marcorispoli/PCB334/(list of files, cad)

Other CAD files:
ESECUTIVI/PM25-334-1.dwg
LAYOUT/25-334-1.dwg
ESECUTIVI/PF25-334-1.dwg
