marcorispoli/PCB334/ORCAD/SE25-334-1.pdf

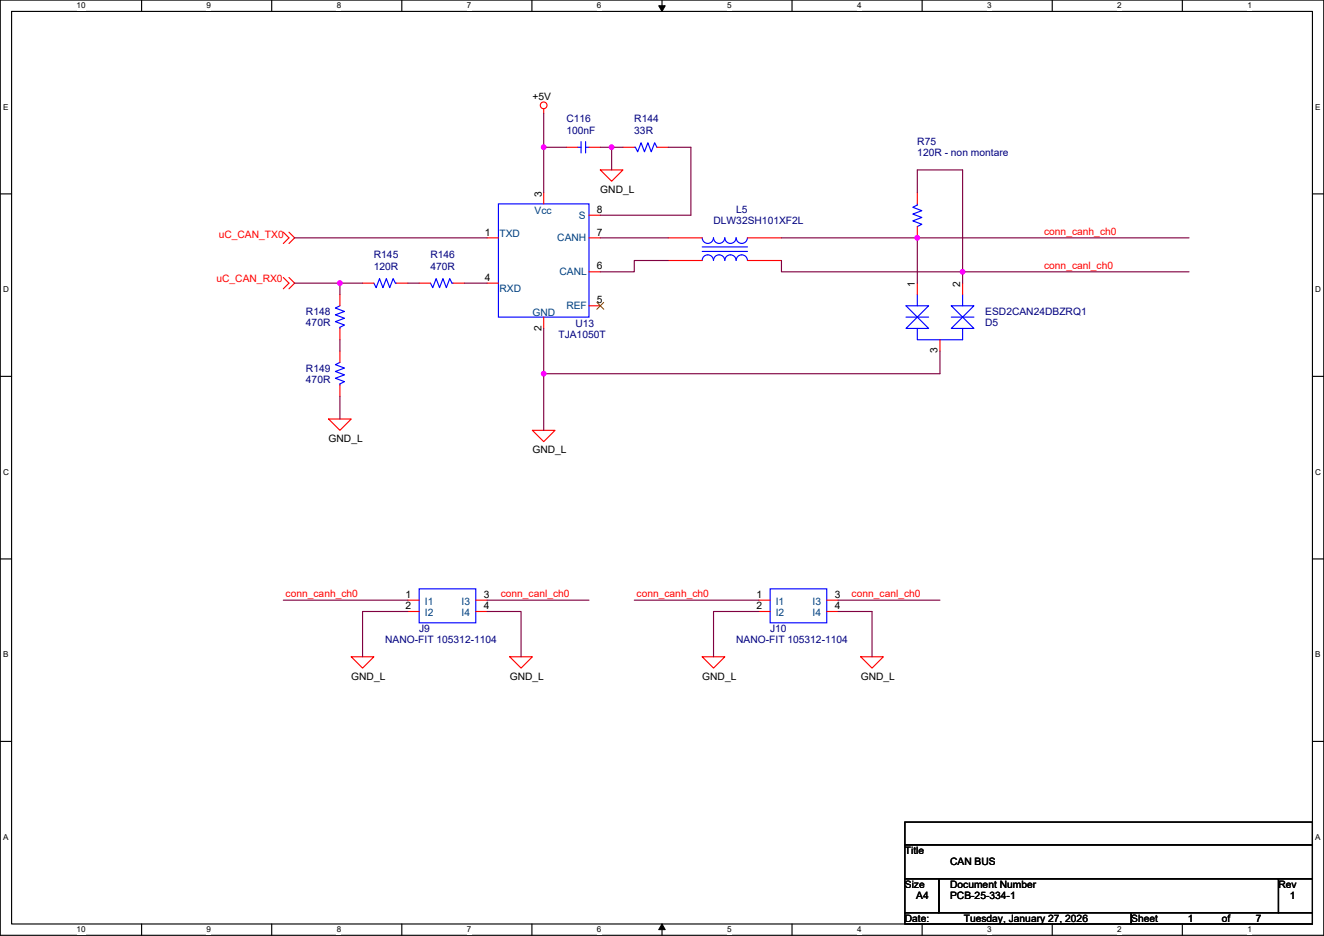
[picture p24: page 1]

Size A4 | Document Number PCB-25-334-1 | Rev 1

Date: Tuesday, January 27, 2026 Tuesday, January 27, 2026 Tuesday, January 27, 2026 | Sheet 1 1 1 of 7 7 7

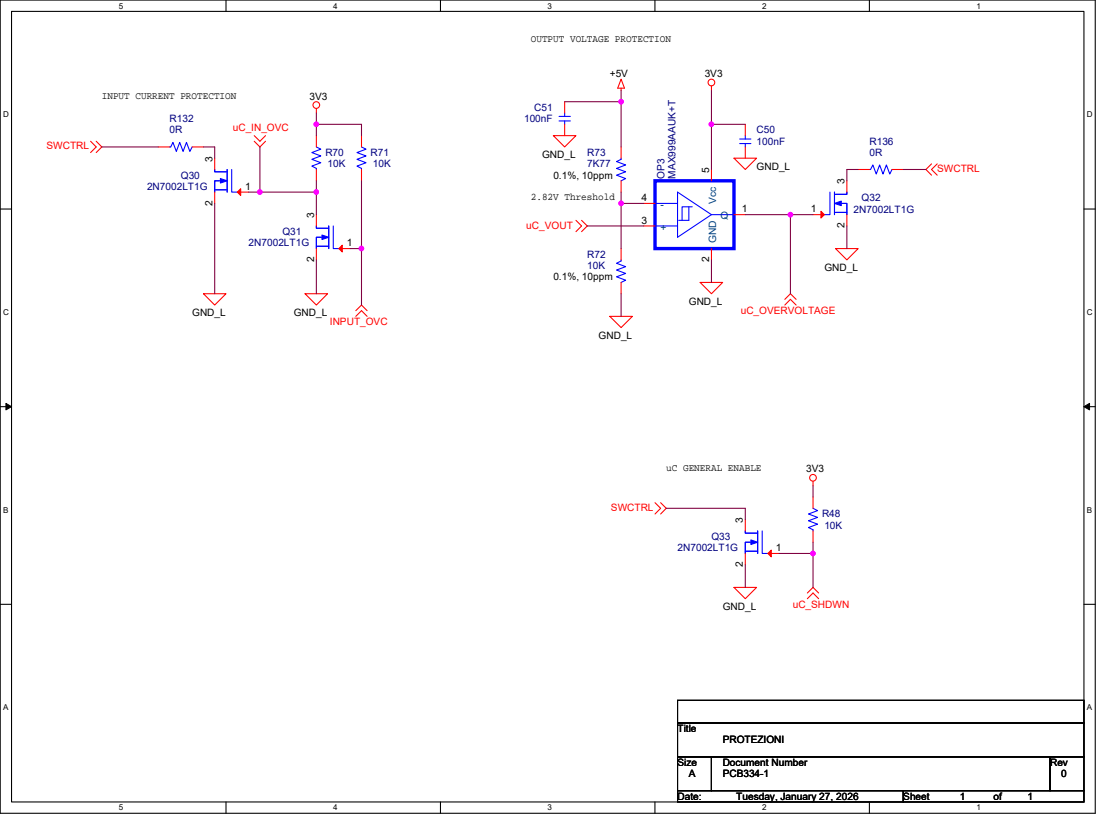
[picture p25: page 2]

A A A | PCB334-1 PCB334-1 PCB334-1 | 0 0 0

Tuesday, January 27, 2026 Tuesday, January 27, 2026 Tuesday, January 27, 2026 | 1 1 1

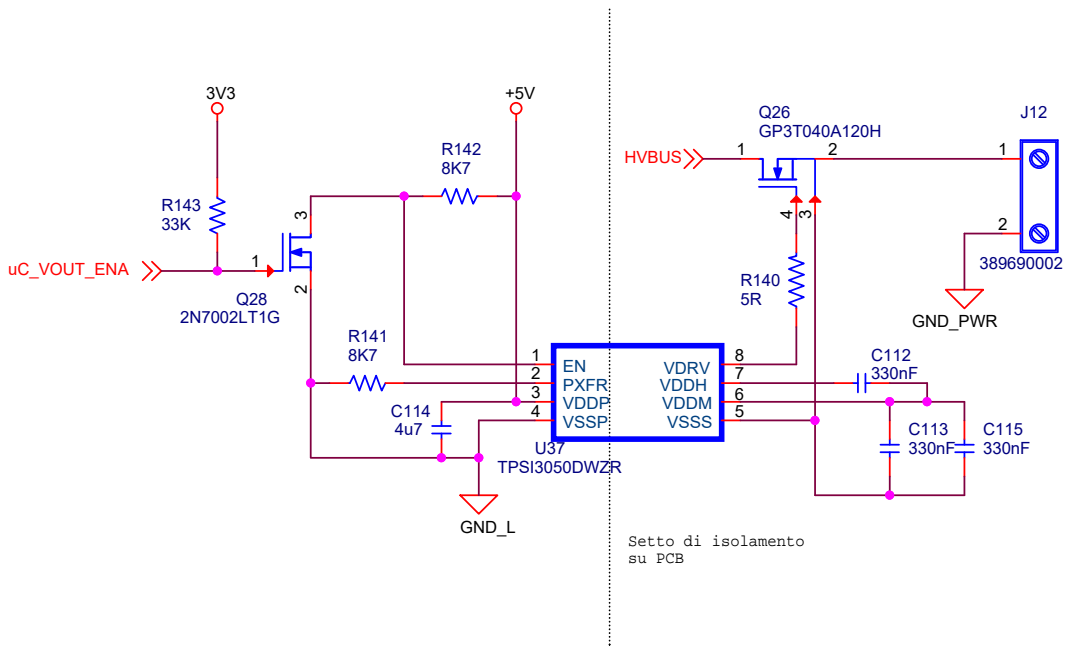
[picture p26: page 3]

Wednesday, January 28, 2026 Wednesday, January 28, 2026 Wednesday, January 28, 2026 | 1 1 1

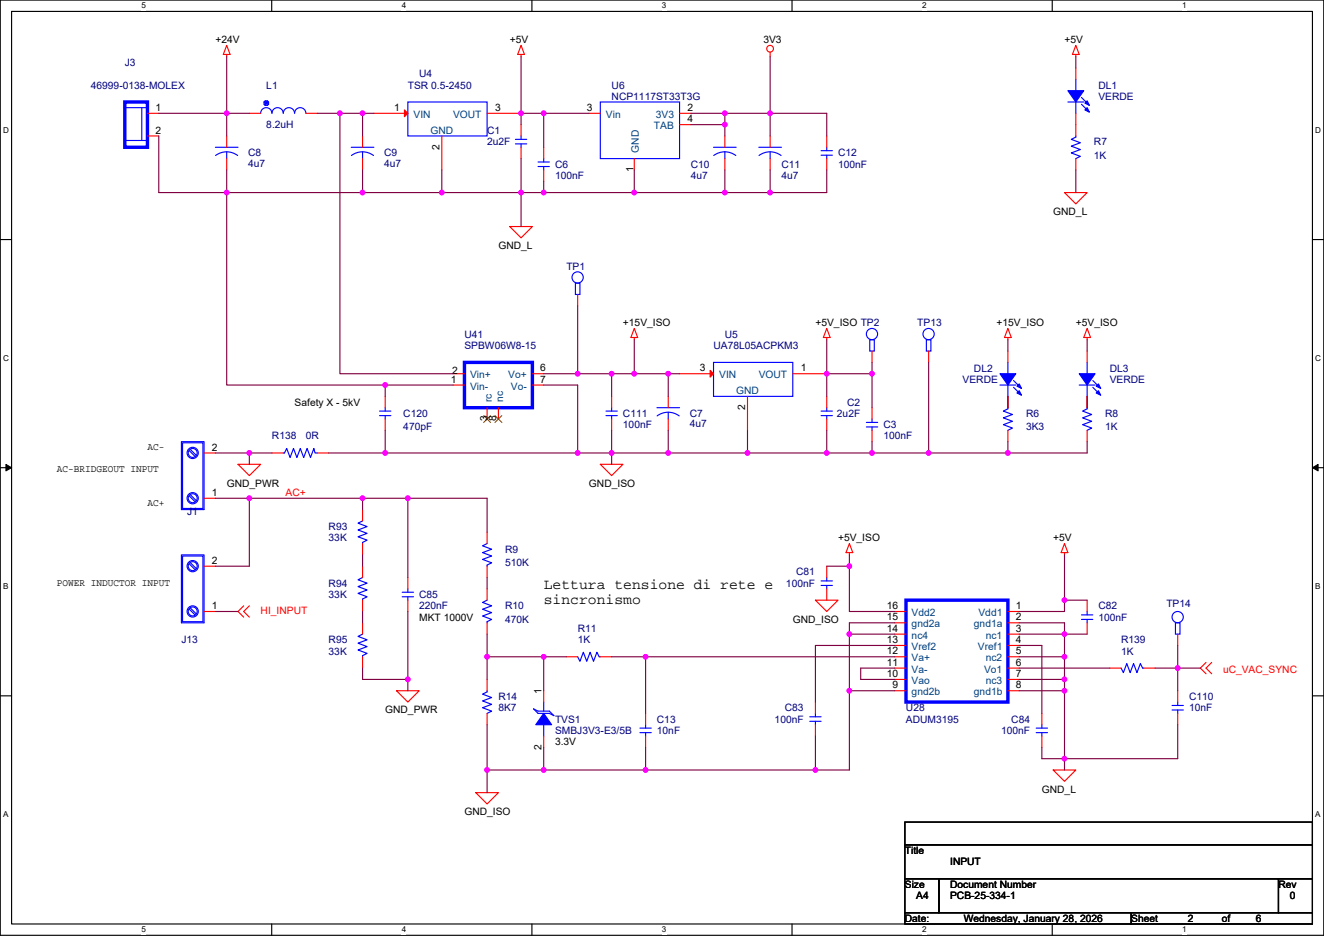
[picture p27: page 4]

AC+ AC-BRIDGEOUT INPUT

## Vref = 0.00477 * Vout Vref(560) = 2.67V

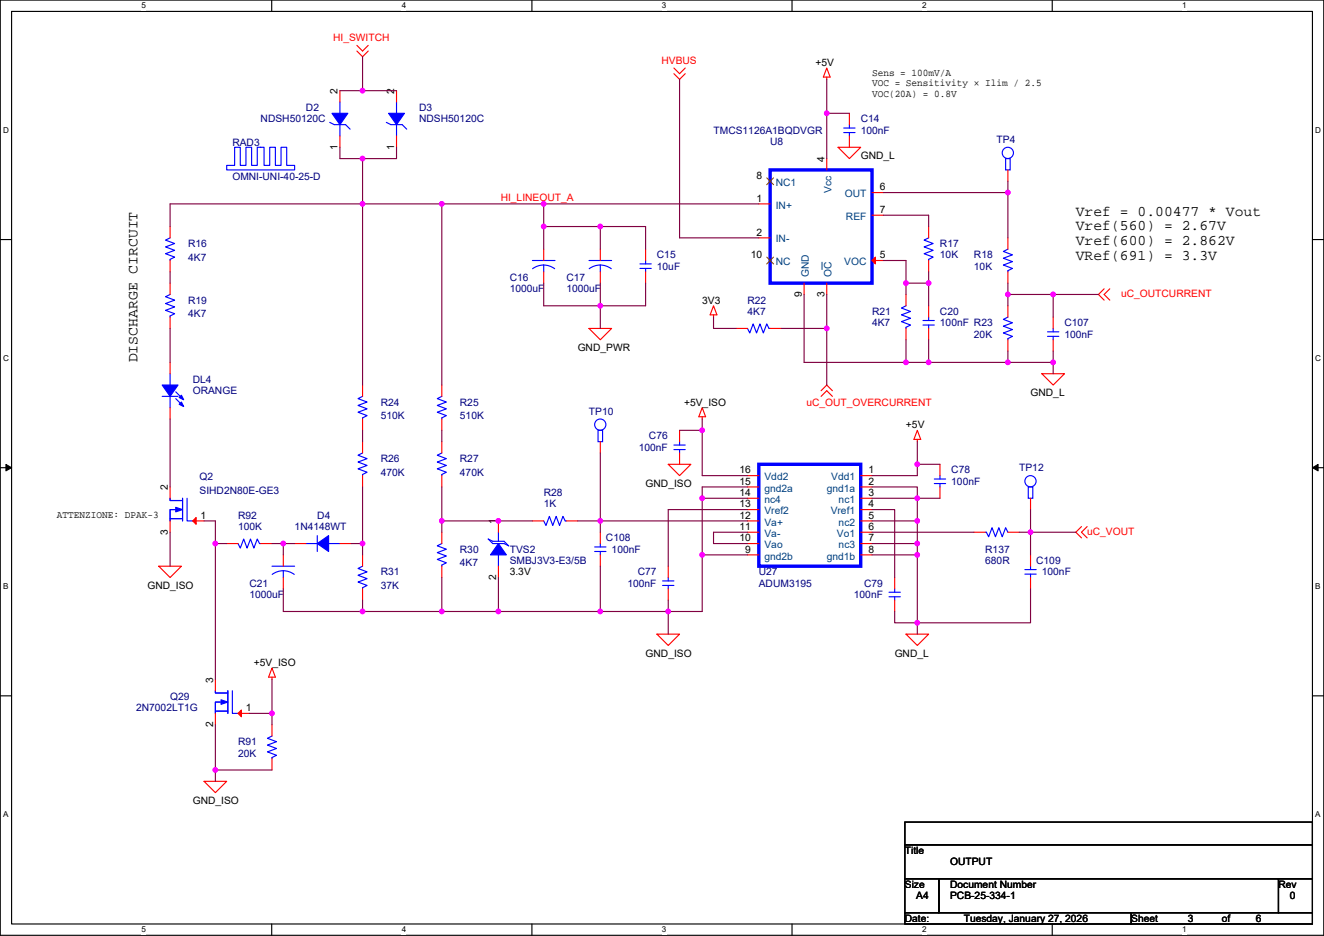
[picture p28: page 5]

# PER ALTE PRESTAZIONI UTILIZZARE: SiC MOSFET ->IMZC120R017M2HXKSA1

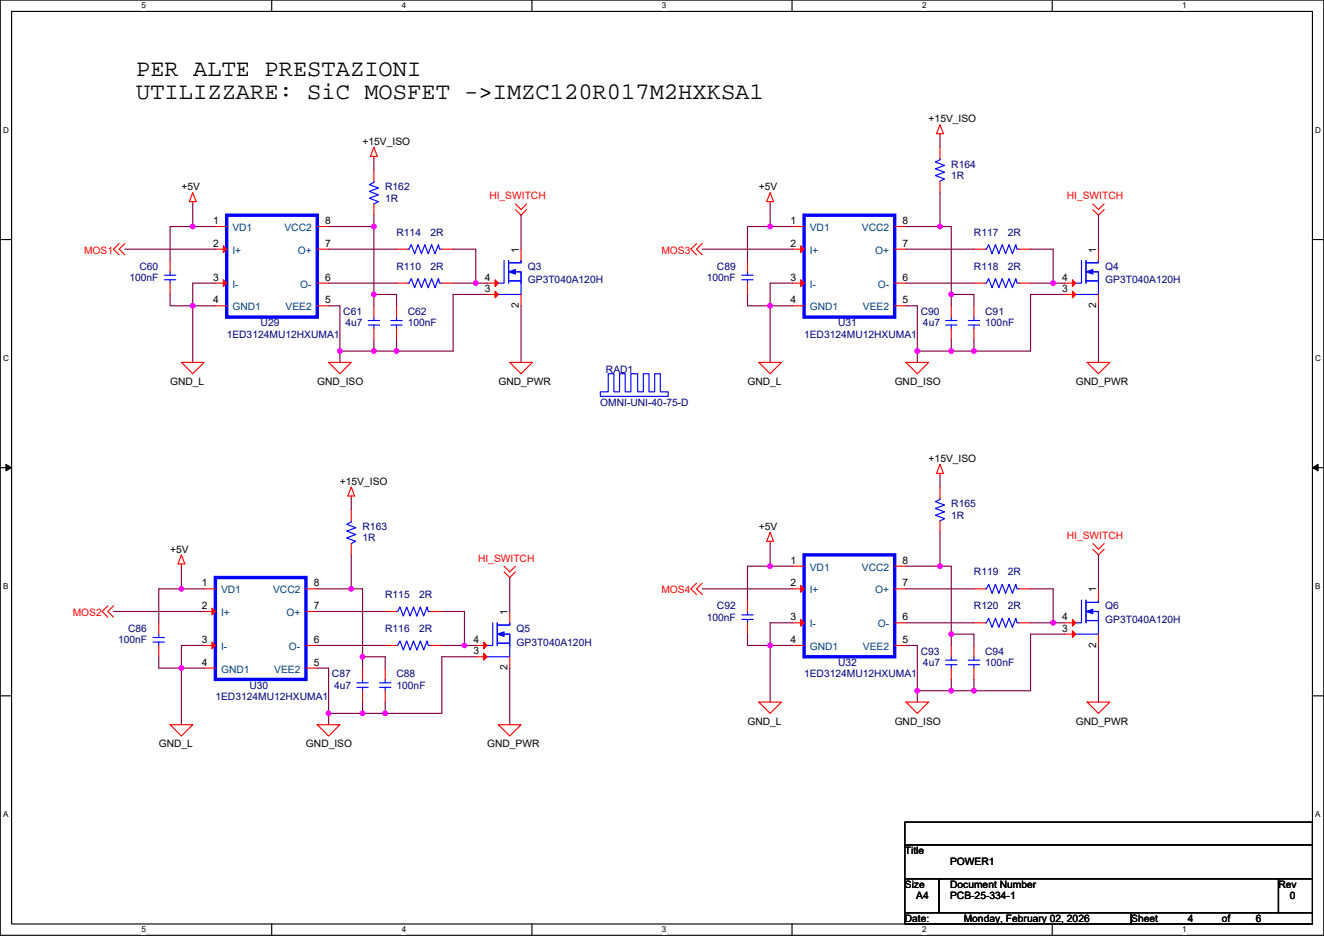
[picture p29: page 6]

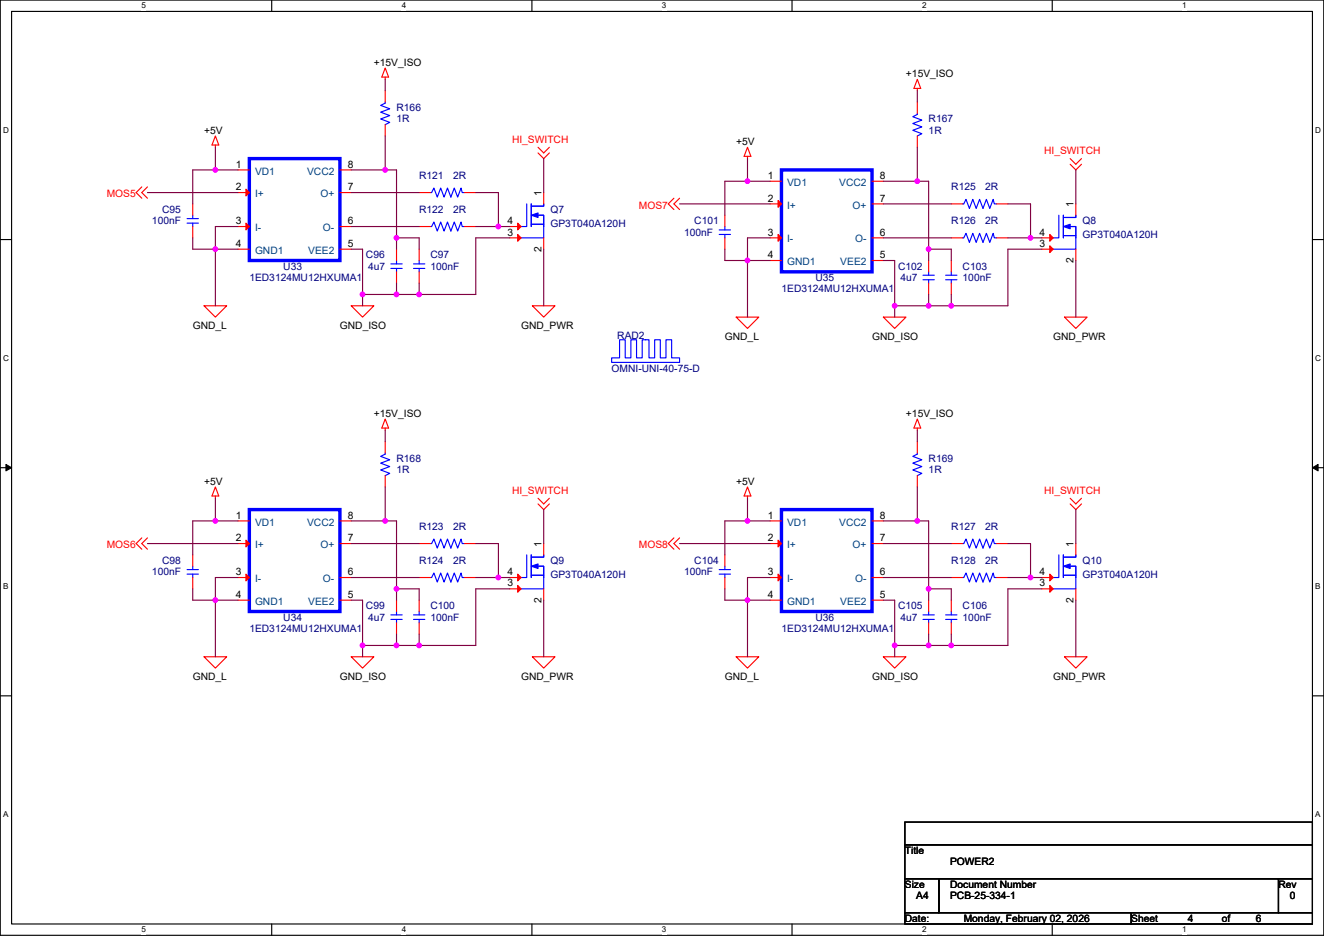
[picture p30: page 7]

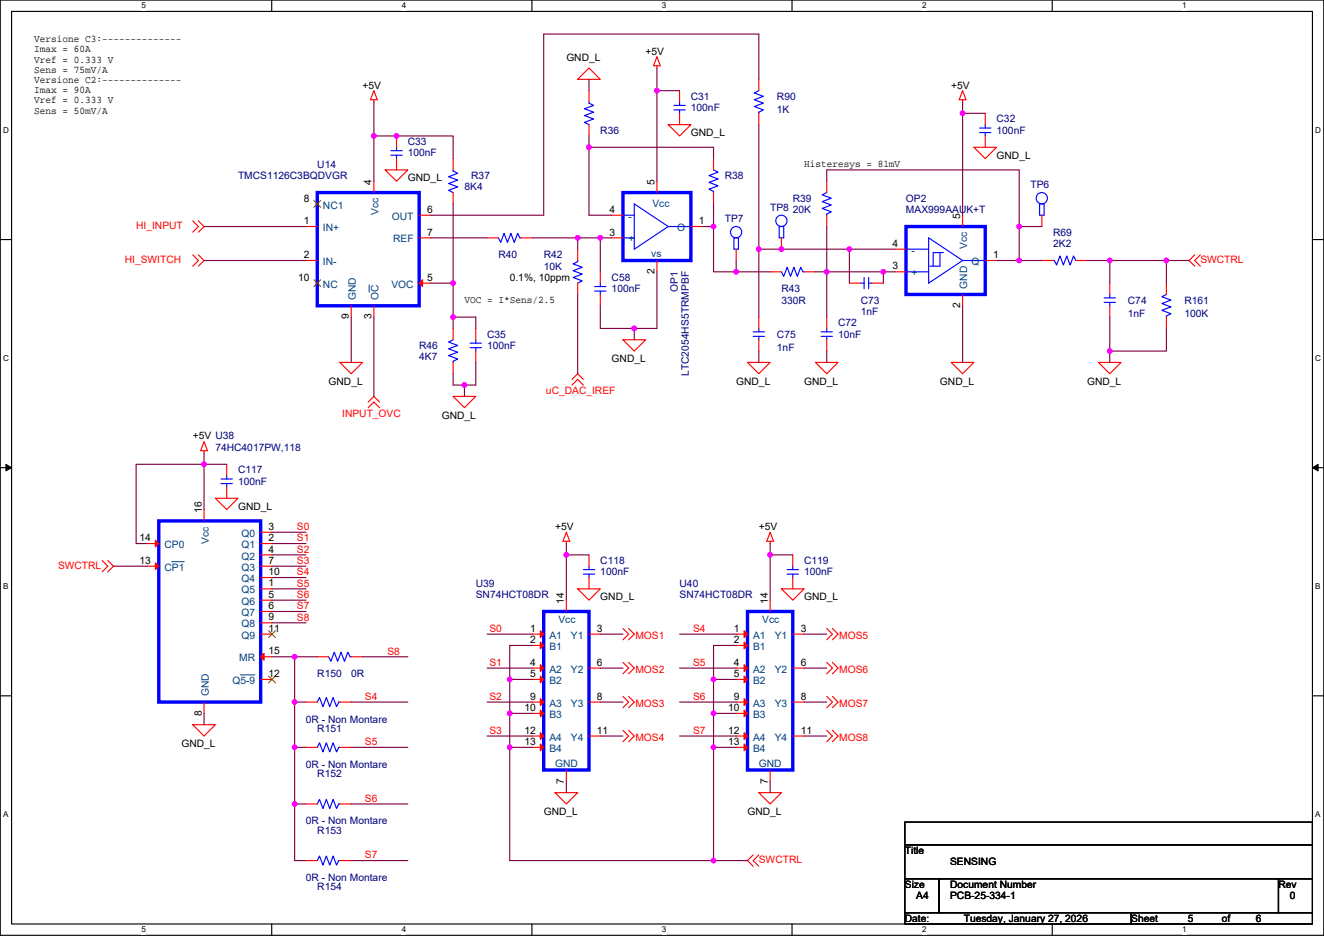
[picture p31: page 8]

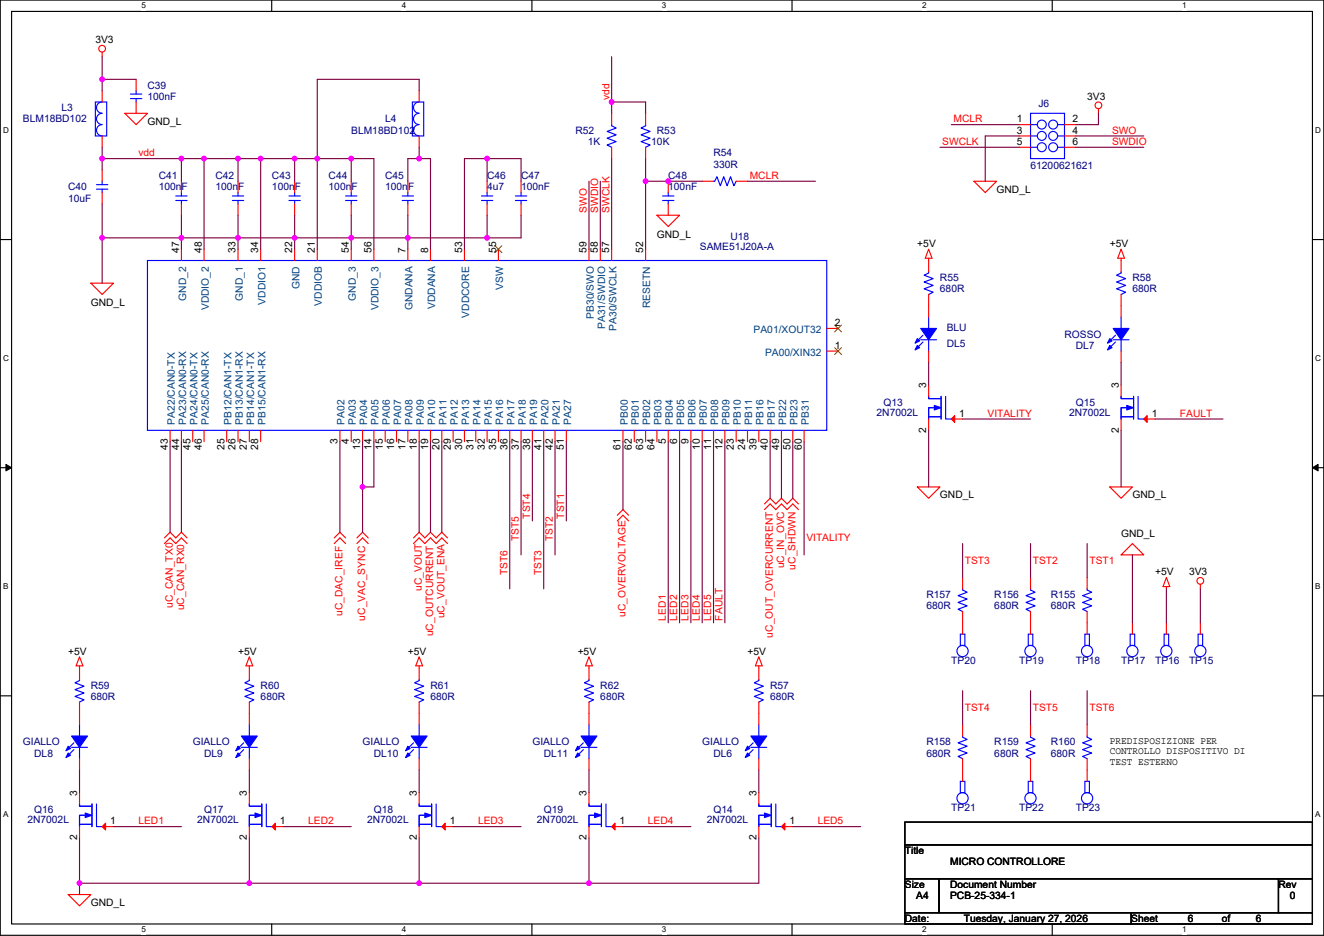
[picture p32: page 9]
