marcorispoli/PCB334/ESECUTIVI/PF25-334-1.pdf

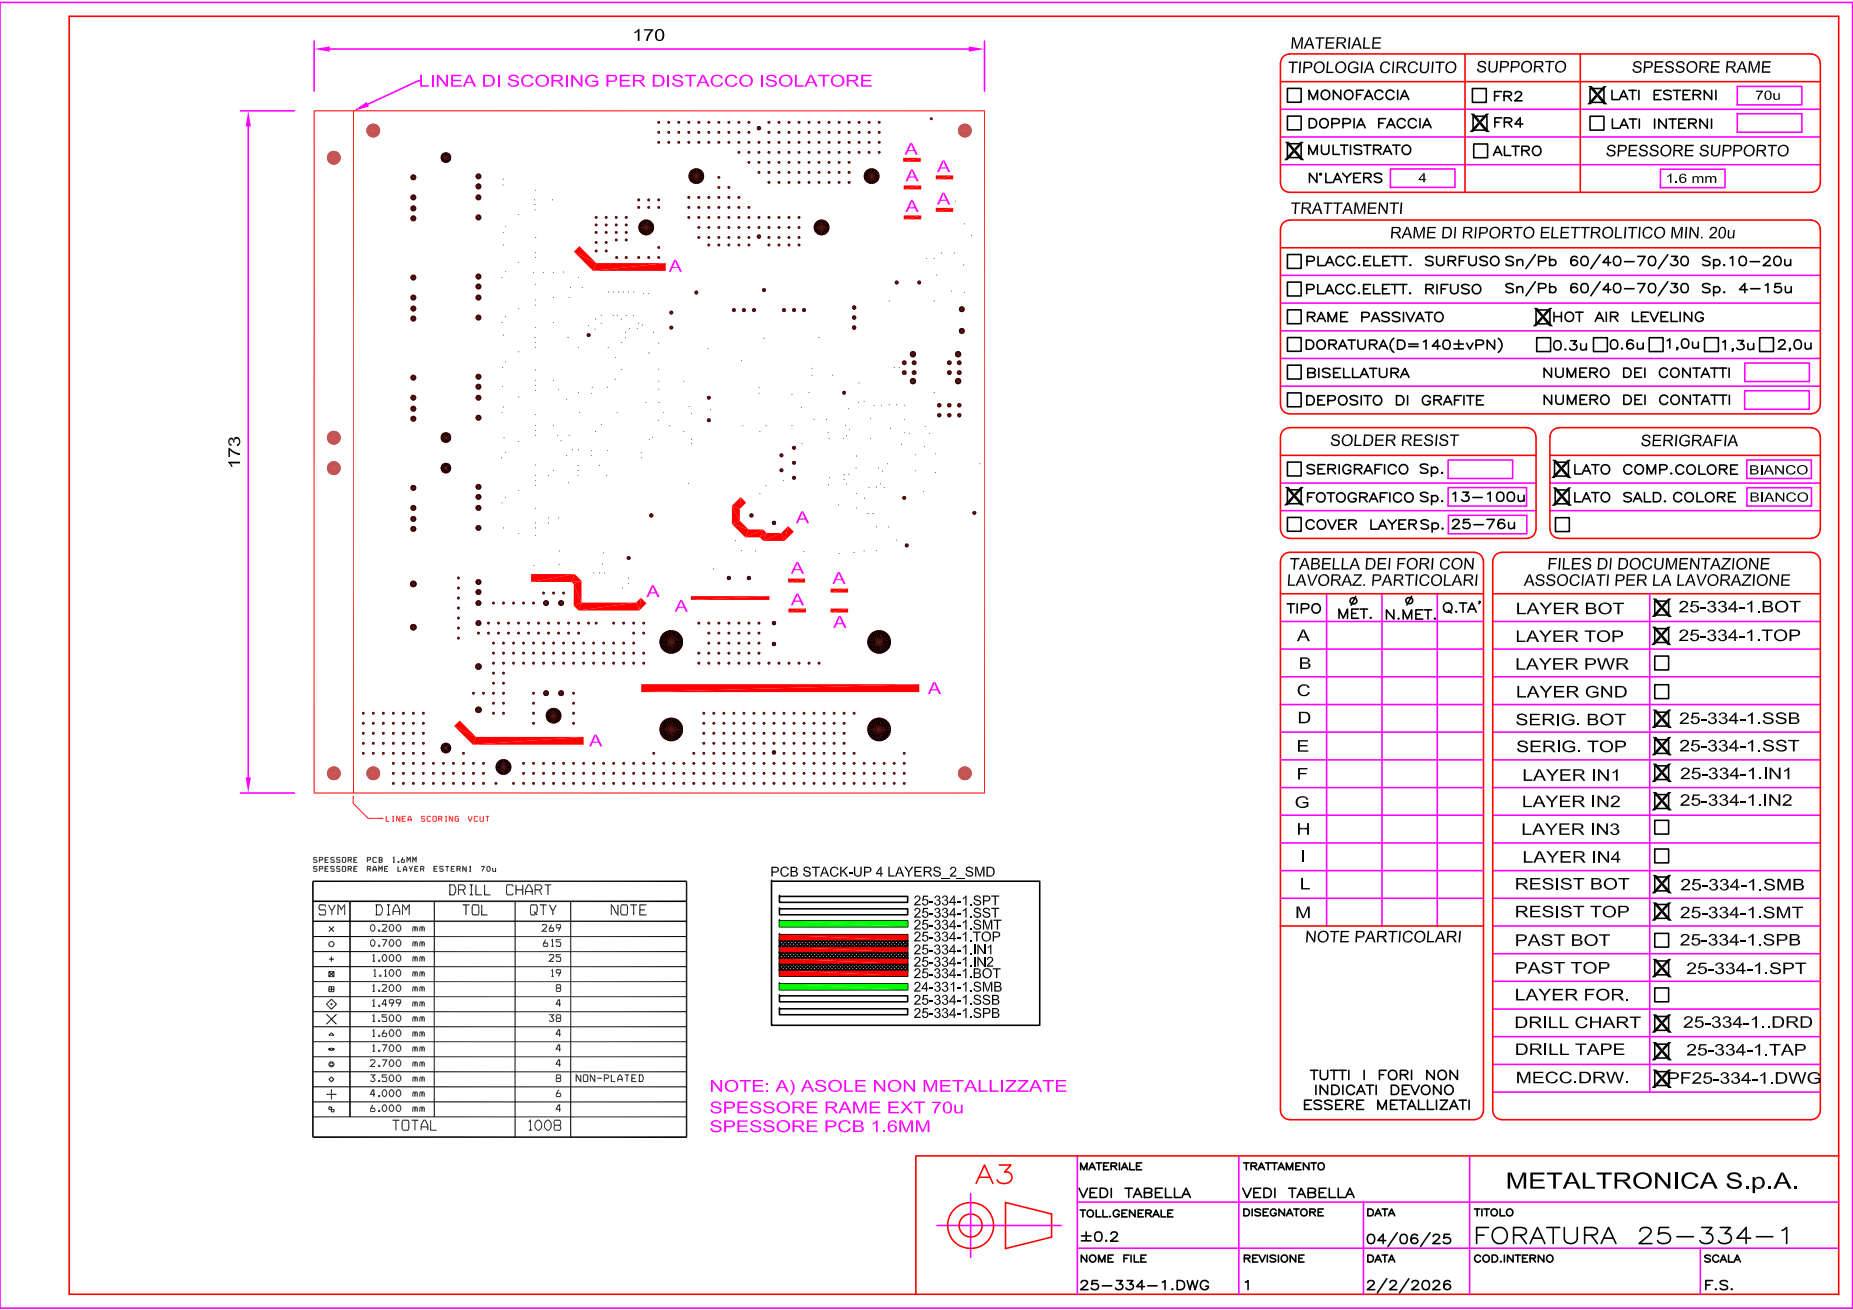
[picture p33: page 1]
