marcorispoli/PCB334/ESECUTIVI/PM25-334-1.pdf

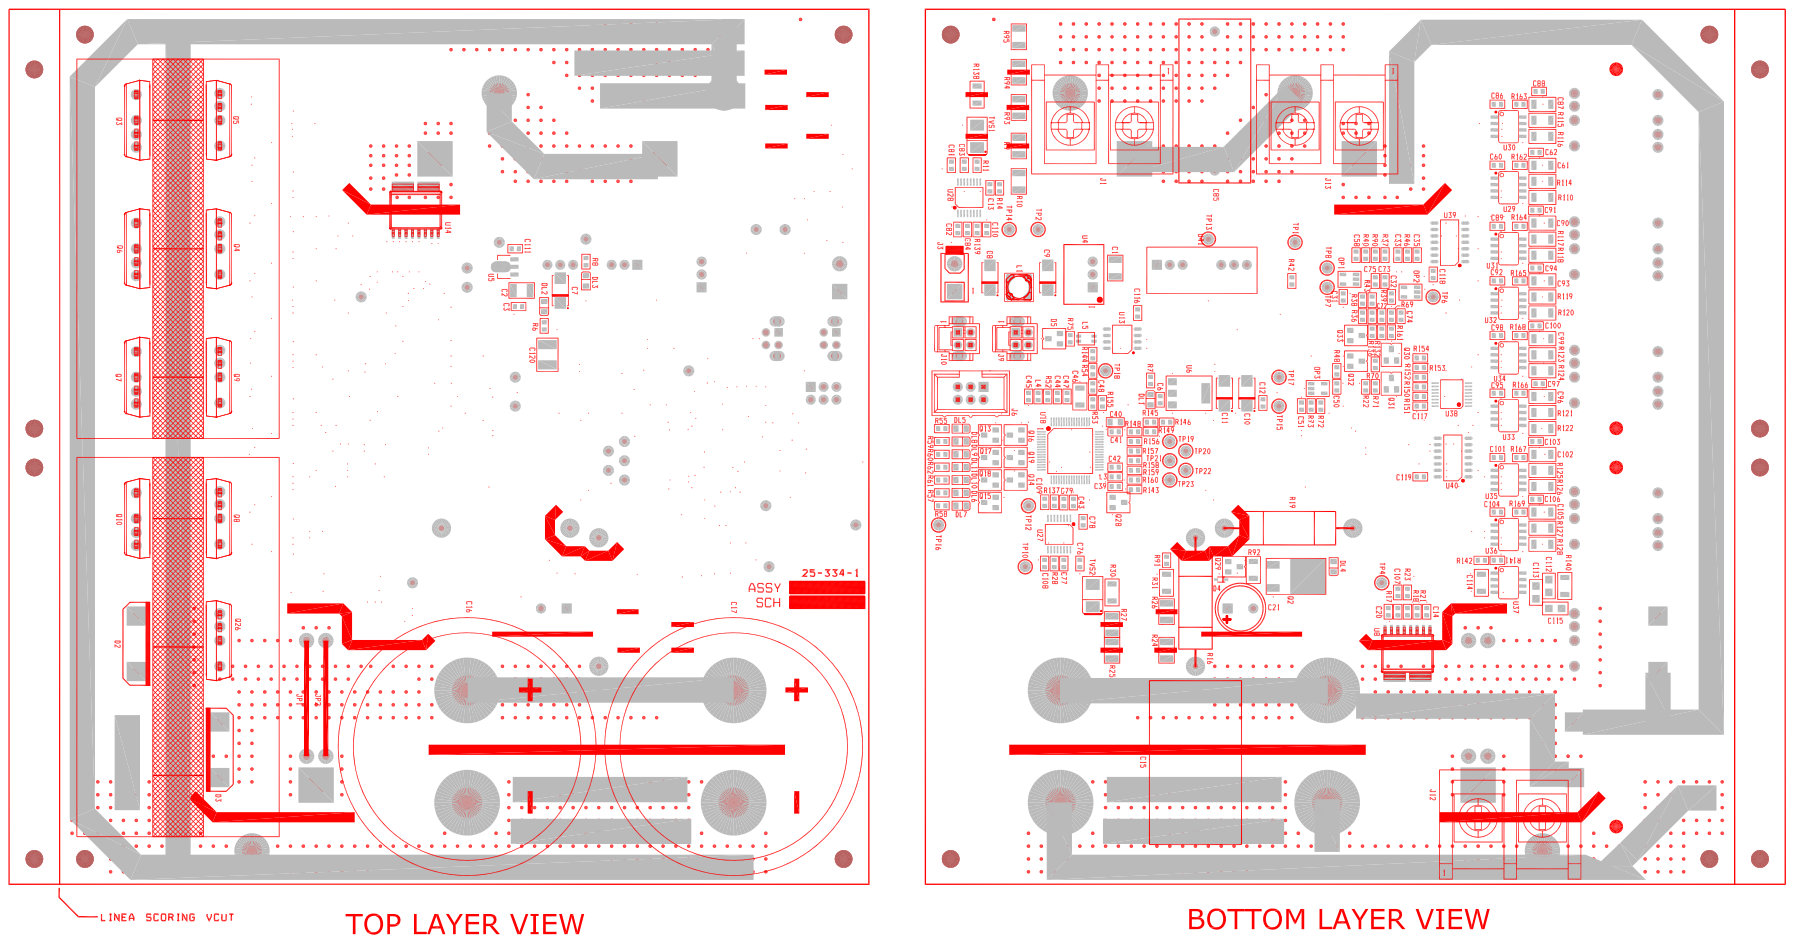
[picture p34: page 1]
