marcorispoli/PCB334/(list of files, drawings)

Other design files:
ORCAD/25-334-1.DSN
ORCAD/25-334-1.opj
