marcorispoli/PCB334/(commit log)

2025-06-03 Aggiunto sbroglio RV0 di Osvaldo per analisi prima della chiusura della scheda
    [25-334-0.DSN, 25-334-0.dwg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]
2025-06-23 REVISIONE 0
    [25-334-0.DSN, 25-334-0.dwg, 25-334-0.opj, LP25-334-0.xlsx, PF25-334-0.dwg, PM25-334-0.dwg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]
2025-06-23 Aggiunto documentazione
    [25-334-0.dwg, PF25-334-0.dwg]
2025-09-08 Aggiunto documento di Note di debug
2025-09-24 Iniziato modifiche per nuova versione isolata
    [25-334-0.DSN, 25-334-0.opj]
2025-12-09 avanzamenti vari
    [25-334-0.DSN, 25-334-0.opj, LIBRARY.OLB]
2026-01-21 Aggiornato schema con modifiche per rev 1
    [25-334-0.DSN, 25-334-0.opj, LIBRARY.OLB]
2026-01-22 Completato modifica verso revisione 1
    [25-334-0.DSN, 25-334-0.opj, LIBRARY.OLB]
2026-02-09 PCB/25-334-1 Release
    [25-334-0.DSN, 25-334-0.dwg, 25-334-0.opj, 25-334-1.DSN, 25-334-1.dwg, 25-334-1.opj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]
2026-02-09 Aggiunto dettagli per lista parti e creazione lista parti
    [25-334-1.opj, BOM-25-334-1.xlsx]
2026-02-10 Corretto esecutivi per errore sul footprint del condensatore Corretto distribuzione pista ISo e relativi componenti Inviato nuovi gerber a Solda
    [25-334-1.DSN, 25-334-1.dwg, 25-334-1.opj, BOM-25-334-1.xlsx, LP25-334-1.xlsx, PF25-334-1.dwg, PM25-334-1.dwg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]
2026-02-11 Aggiornato Lista Parti (inviata a uff acq)
    [LP25-334-1.xlsx, LP25-334-1_ASSY00_REV00.xlsx]
